elmot/FoxilloScope/DEVELOPMENT.md

# FoxilloScope – Developer & Contributor Guide

This guide provides technical information for developers building firmware, setting up hardware debug configurations, and contributing to the FoxilloScope project.

For end-user quick start instructions and assembly steps, see [README.md](README.md).

---

## 🤖 AI-Assisted Development Invitation

Feel free to use AI coding agents (such as Google Antigravity, Claude, ChatGPT, Cursor, etc.) to modify, extend, or adapt this project to your needs!

To make AI pair-programming seamless and reliable, dedicated **`AGENTS.md`** context files are placed throughout every subsystem directory:
- **Root / STM32 Firmware**: [AGENTS.md](AGENTS.md) – Covers MCU AFE scaling math, ADC phase interleaving, trigger engine, and dual UART DMA transmission.
- **ESP32 Gateway Subsystem**: [esp32-gateway/AGENTS.md](esp32-gateway/AGENTS.md) – Covers WebSocket/BLE streaming, network configuration, and AN3155 in-application STM32 firmware flashing.
- **Web Frontend Subsystem**: [html/AGENTS.md](html/AGENTS.md) – Covers uPlot integration, custom canvas drawing hooks, parameter scaling, and gesture interactions.

---

## Subsystem Architecture & Codebase Structure

The project is split into three main software components:

- **[STM32 Firmware](AGENTS.md)** (`Core/`) – Runs on the STM32G474RET6 MCU. Handles high-speed ADC sampling, hardware AFE scaling, trigger logic, and dual UART DMA transmission.
- **[ESP32 Gateway Firmware](esp32-gateway/AGENTS.md)** (`esp32-gateway/`) – ESP-IDF v6.0 project. While an M5Stamp C3U (ESP32-C3) is used by default, **any Wi-Fi/BLE-enabled ESP32 chip or board** (e.g., ESP32, ESP32-C3/C5/C6, ESP32-S2/S3) supported by ESP-IDF can be used. Refer to the official [ESP-IDF Target Hardware Documentation](https://docs.espressif.com/projects/esp-idf/en/v6.0/esp32/get-started/index.html#target-hardware) for configuring alternative target chips (`idf.py set-target <chip>`).
- **[Web Frontend](html/AGENTS.md)** (`html/`) – Single-page HTML/JS application (`index.html`) using uPlot for real-time waveform rendering, gesture interactions, gain scaling, and measurement readouts.
- **Hardware Documentation** (`docs/`) – Wiring diagrams, pin maps, and schematics.
- **Python Debug Server** (`py/`) – Local desktop development bridge over USB Serial.

---

## Hardware Configuration & Jumper Settings

All hardware modifications, jumper settings (Production vs. Development modes), and pin diagnostics are documented in the **[Hardware Guide (docs/HARDWARE.md)](docs/HARDWARE.md)**:
- **Production Mode**: See [docs/HARDWARE.md#2-jumper-configurations](docs/HARDWARE.md#2-jumper-configurations)
- **Development & ST-LINK Debug Mode**: See [docs/HARDWARE.md#2-jumper-configurations](docs/HARDWARE.md#2-jumper-configurations)
- **Nucleo Board Solder Bridges**: See [docs/HARDWARE.md](docs/HARDWARE.md#1-nucleo-g474re-board-modifications-mandatory)
- **Hardware Verification (`pin_check`)**: See [docs/HARDWARE.md](docs/HARDWARE.md#4-hardware-verification-with-pin_check)

---

## Python Debug Server (Desktop Development)

From the repository root, create a local virtual environment and install the Python dependencies:

```sh
python3 -m venv .venv
source .venv/bin/activate
python -m pip install -r py/requirements.txt
cd py
```

The `.venv` directory is ignored by Git.

For local web UI development without needing the ESP32 gateway hardware, run the Python debug server ([py/chart_server.py](py/chart_server.py)) on a desktop PC:

```sh
python chart_server.py
```

This bridges the STM32's USB Virtual COM port (LPUART1) directly to a local WebSocket server at `http://localhost:8000/`.

### Mock Oscilloscope Server (No Hardware)

To run the complete browser UI without an STM32 or ESP32, start the synthetic signal server:

```sh
python mock_server.py
```

Open `http://localhost:8000/`, select **Oscilloscope UI**, and click the Wi-Fi button. The mock server streams a 50 Hz sine wave on channel A and a 20 Hz square wave on channel B, so changing the sampling timescale changes the visible time span just as it would for physical signals. Trigger keyframes follow the selected channel, threshold, slope, and time offset.

If port 8000 is already in use, stop the existing server or select another port with `python mock_server.py --port 8001`. Run `python mock_server.py --help` for all options.

Run the mock server tests with:

```sh
python -m unittest -v test_mock_server.py
```

---

## Tools Used & Reference Links

- **STM32 Firmware**:
  - [STM32CubeMX](https://www.st.com/en/development-tools/stm32cubemx.html) – Graphical peripheral configuration tool
  - [STM32CubeCLT](https://www.st.com/en/development-tools/stm32cubeclt.html) – Command-line build toolset and GCC ARM toolchain
  - [JetBrains CLion](https://www.jetbrains.com/clion/) – Cross-platform C/C++ IDE
- **ESP32 Gateway**:
  - [Espressif ESP-IDF v6.0](https://docs.espressif.com/projects/esp-idf/en/v6.0/esp32/) – Official development framework for ESP32 chips
- **Schematics & Wiring**:
  - [DigiKey Scheme-it](https://www.digikey.com/schemeit/project/) – Free online schematic capture tool
- **Web Frontend**:
  - Vanilla JavaScript
  - [uPlot](https://github.com/leeoniya/uPlot) – Fast, lightweight 2D canvas charting engine
  - [Lucide Icons](https://lucide.dev/) – Open-source icon library

---

## Documentation References

- User Guide & Assembly: [README.md](README.md)
- STM32 Architecture Reference: [AGENTS.md](AGENTS.md)
- ESP32 Gateway Architecture Reference: [esp32-gateway/AGENTS.md](esp32-gateway/AGENTS.md)
- Frontend Architecture Reference: [html/AGENTS.md](html/AGENTS.md)
- Pinout & Wiring Mapping: [docs/wiring_diagram.html](docs/wiring_diagram.html)
- _(requires LibreOffice or OpenOffice)__ Peripheral functions and pins spreadsheet [docs/foxilloscope_peripherals.fods](docs/foxilloscope_peripherals.fods)
