elmot/FoxilloScope/docs/nucleo-g474re-bottom.jpg

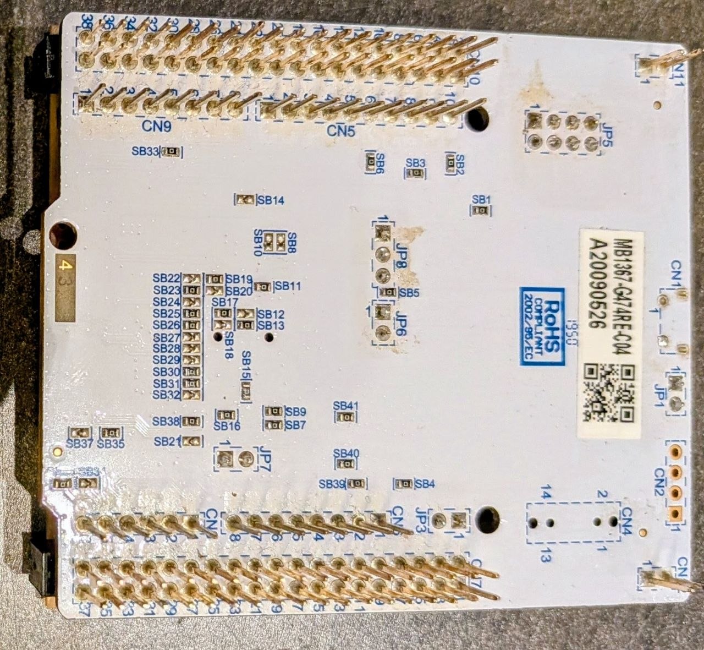
docs/nucleo-g474re-bottom.jpg
