elmot/FoxilloScope/docs/nucleo-g474re-pinout.png

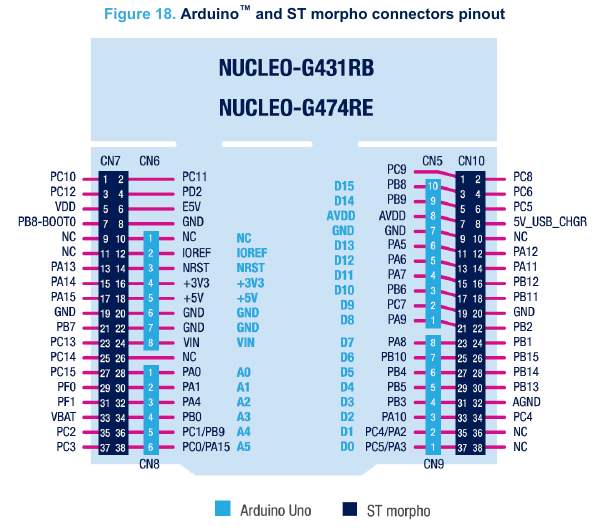
docs/nucleo-g474re-pinout.png
