elmot/FoxilloScope/html/screenshot1.png

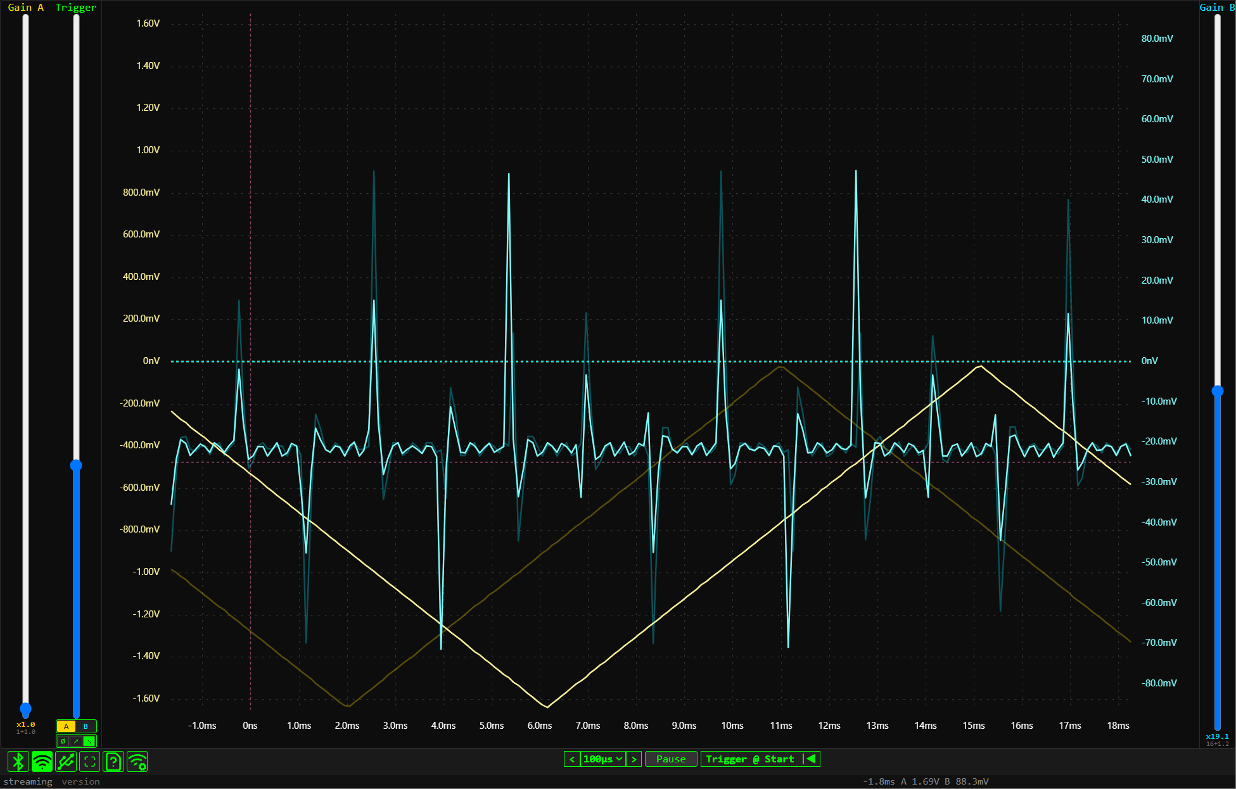
html/screenshot1.png
