elmot/FoxilloScope/html/sticker/background.png

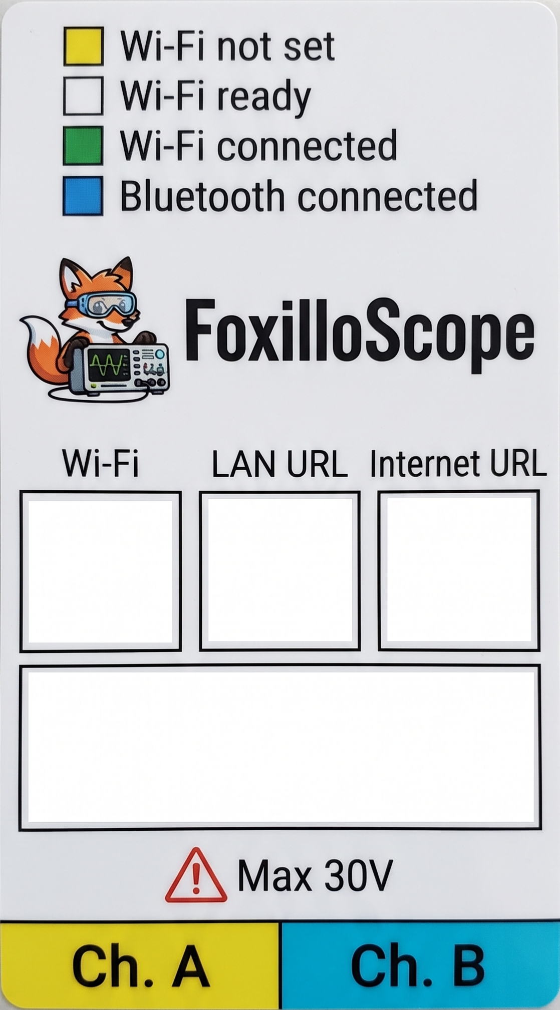
html/sticker/background.png
