elmot/FoxilloScope/Foxilloscope - stripboard.pdf

## Foxilloscope | placement (component side)

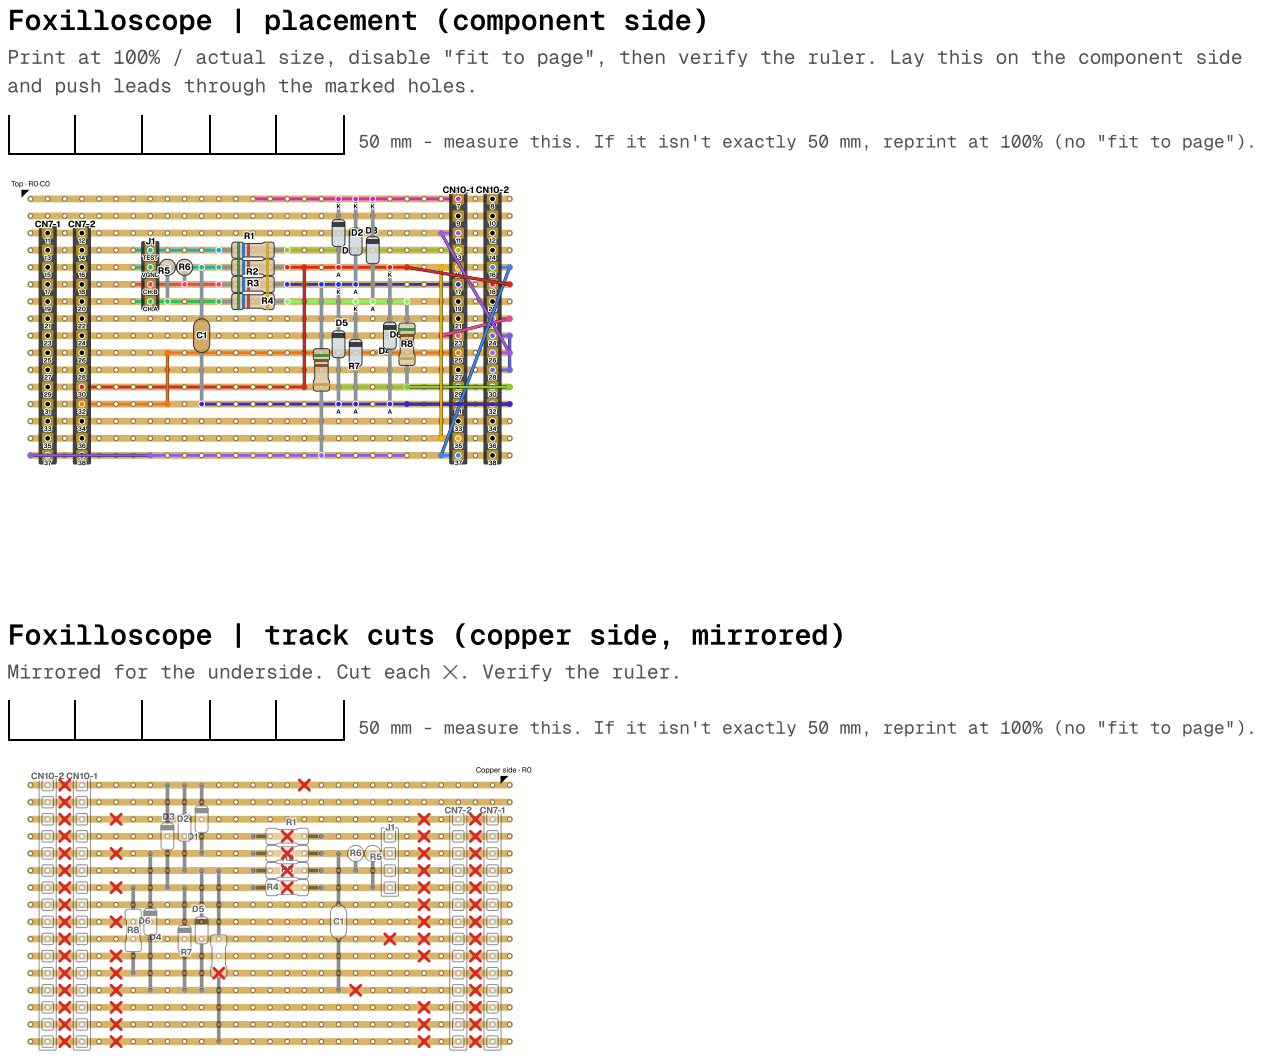
[picture p11: page 1]

Print at 100% / actual size, disable "fit to page", then verify the ruler. Lay this on the component side
and push leads through the marked holes.

50 mm - measure this. If it isn't exactly 50 mm, reprint at 100% (no "fit to page").

Foxilloscope | track cuts (copper side, mirrored)
Mirrored for the underside. Cut each ✕. Verify the ruler.
