elmot/FoxilloScope/foxilloscope.ioc

Mcu.UserName=STM32G474RETx
PA1.GPIO_Label=OPAMP3.IN+[VGND]
PA1.Signal=OPAMP3_VINP
PA13.Signal=SYS_JTMS-SWDIO
PA14.Signal=SYS_JTCK-SWCLK
PA2.GPIO_Label=ADC1.3, OPAMP1_OUT[_SIGNAL.A]
PA2.Signal=SharedAnalog_PA2
PA3.GPIO_Label=OPAMP1.IN-[_STAGE.A]
PA3.Signal=OPAMP1_VINM0
PA4.GPIO_Label=DAC1.1[_BIAS.A]
PA4.Signal=COMP_DAC11_group
PA5.GPIO_Label=DAC1.2[_BIAS.B]
PA5.Signal=COMP_DAC12_group
PA6.GPIO_Label=DAC2.1[TEST.SIGNAL]
PA6.Signal=COMP_DAC21_group
PA7.GPIO_Label=ADC2.4,COMP2+[_SIGNAL_A]
PA7.Signal=SharedAnalog_PA7
PA8.GPIO_Label=OPAMP5.OUT[_STAGE.B]
PA8.Signal=OPAMP5_VOUT
PB1.GPIO_Label=OPAMP3.OUT,ADC3.1[_SIGNAL.B]
PB1.Signal=SharedAnalog_PB1
PB10.GPIO_Label=OPAMP4.IN-[_BIAS.A]
PB10.Signal=OPAMP4_VINM0
PB11.GPIO_Label=OPAMP6.OUT[VGND]
PB11.Signal=OPAMP6_VOUT
PB12.GPIO_Label=OPAMP4.OUT[_STAGE.A]
PB12.Signal=OPAMP4_VOUT
PB13.GPIO_Label=OPAMP4.IN+[IN.A]
PB13.Signal=OPAMP4_VINP
PB14.GPIO_Label=ADC4.4, COMP7+[_SIGNAL.B]
PB14.Signal=SharedAnalog_PB14
PB15.GPIO_Label=OPAMP5.IN-[_BIAS.B]
PB15.Signal=OPAMP5_VINM0
PB2.GPIO_Label=OPAMP3.IN-[_STAGE.B]
PB2.Signal=OPAMP3_VINM0
PC10.GPIO_Label=UART4.TX[EXT.UART.TX]
PC10.Signal=UART4_TX
PC11.GPIO_Label=UART4.RX[EXT.UART.RX]
PC11.Signal=UART4_RX
PC3.GPIO_Label=OPAMP5.IN+[IN.B]
PC3.Signal=OPAMP5_VINP
PC4.Signal=USART1_TX
PC5.Signal=USART1_RX
PF0-OSC_IN.Signal=RCC_OSC_IN
PF1-OSC_OUT.Signal=RCC_OSC_OUT
