elmot/FoxilloScope/Core/Src/main.c

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
/* Includes ------------------------------------------------------------------*/
#include "main.h"
#include "cmsis_os.h"
#include "adc.h"
#include "comp.h"
#include "dac.h"
#include "dma.h"
#include "opamp.h"
#include "tim.h"
#include "usart.h"
#include "gpio.h"


void SystemClock_Config(void);
void MX_FREERTOS_Init(void);
/* USER CODE BEGIN 0 */
void startSysBootloader(void)
{
  __disable_irq();

  /* Stop peripherals, SysTick, DMA, etc. */

  HAL_RCC_DeInit();
  HAL_DeInit();

  SysTick->CTRL = 0;
  SysTick->LOAD = 0;
  SysTick->VAL = 0;

  /* Remap System Memory */
  __HAL_SYSCFG_REMAPMEMORY_SYSTEMFLASH();

  /* Load MSP from System Memory */
  const uint32_t bootAddr = 0x1FFF0000;   // STM32G4 System Memory start
  __set_MSP(*(uint32_t *)bootAddr);

  /* Jump to Reset_Handler in System Memory */
  void (*SysMemBootJump)(void) = (void (*)(void))(*(uint32_t*)(bootAddr + 4));
  SysMemBootJump();

}
/* USER CODE END 0 */

/**
  * @brief  The application entry point.
  * @retval int
  */
int main(void)
{

  /* MCU Configuration--------------------------------------------------------*/

  /* Reset of all peripherals, Initializes the Flash interface and the Systick. */
  HAL_Init();

  /* Configure the system clock */
  SystemClock_Config();

  /* Initialize all configured peripherals */
  MX_GPIO_Init();
  MX_DMA_Init();
  MX_DAC1_Init();
  MX_TIM1_Init();
  MX_TIM15_Init();
  MX_TIM2_Init();
  MX_DAC3_Init();
  MX_ADC1_Init();
  MX_ADC2_Init();
  MX_UART4_Init();
  MX_ADC3_Init();
  MX_ADC4_Init();
  MX_DAC2_Init();
  MX_USART1_UART_Init();
  MX_OPAMP6_Init();
  MX_OPAMP1_Init();
  MX_OPAMP4_Init();
  MX_OPAMP3_Init();
  MX_OPAMP5_Init();
  MX_COMP2_Init();
  MX_COMP7_Init();
  MX_DAC4_Init();
  /* Init scheduler */
  osKernelInitialize();  /* Call init function for freertos objects (in cmsis_os2.c) */
  MX_FREERTOS_Init();

  /* Start scheduler */
  osKernelStart();

  /* We should never get here as control is now taken by the scheduler */

  /* Infinite loop */
}

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
/**
  * @brief  Period elapsed callback in non blocking mode
  * @note   This function is called  when TIM7 interrupt took place, inside
  * HAL_TIM_IRQHandler(). It makes a direct call to HAL_IncTick() to increment
  * a global variable "uwTick" used as application time base.
  * @param  htim : TIM handle
  * @retval None
  */
void HAL_TIM_PeriodElapsedCallback(TIM_HandleTypeDef *htim)
{
  if (htim->Instance == TIM7)
  {
    HAL_IncTick();
  }
}

/**
  * @brief  This function is executed in case of error occurrence.
  * @retval None
  */
void Error_Handler(void)
{
  /* USER CODE BEGIN Error_Handler_Debug */
  /* User can add his own implementation to report the HAL error return state */
  __disable_irq();
  // ReSharper disable once CppDFAEndlessLoop
  while (1)
  {
  }
  /* USER CODE END Error_Handler_Debug */
}
#ifdef USE_FULL_ASSERT
/**
  * @brief  Reports the name of the source file and the source line number
  *         where the assert_param error has occurred.
  * @param  file: pointer to the source file name
  * @param  line: assert_param error line source number
  * @retval None
  */
void assert_failed(uint8_t *file, uint32_t line)
{
  /* USER CODE BEGIN 6 */
  /* User can add his own implementation to report the file name and line number,
     ex: printf("Wrong parameters value: file %s on line %d\r\n", file, line) */
  /* USER CODE END 6 */
}
#endif /* USE_FULL_ASSERT */
