elmot/FoxilloScope/Core/Src/adc.c

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
/* Includes ------------------------------------------------------------------*/
#include "adc.h"

/* USER CODE BEGIN 0 */
#include "cmsis_os2.h"
#include "tim.h"
#include "stdbool.h"

/* USER CODE END 0 */

ADC_HandleTypeDef hadc1;
ADC_HandleTypeDef hadc2;
ADC_HandleTypeDef hadc3;
ADC_HandleTypeDef hadc4;
DMA_HandleTypeDef hdma_adc1;
DMA_HandleTypeDef hdma_adc3;

/* ADC1 init function */
void MX_ADC1_Init(void)
{

  ADC_MultiModeTypeDef multimode = {0};
  ADC_ChannelConfTypeDef sConfig = {0};
  ADC_InjectionConfTypeDef sConfigInjected = {0};

  /** Common config
  */
  hadc1.Instance = ADC1;
  hadc1.Init.ClockPrescaler = ADC_CLOCK_ASYNC_DIV1;
  hadc1.Init.Resolution = ADC_RESOLUTION_12B;
  hadc1.Init.DataAlign = ADC_DATAALIGN_RIGHT;
  hadc1.Init.GainCompensation = 0;
  hadc1.Init.ScanConvMode = ADC_SCAN_DISABLE;
  hadc1.Init.EOCSelection = ADC_EOC_SINGLE_CONV;
  hadc1.Init.LowPowerAutoWait = DISABLE;
  hadc1.Init.ContinuousConvMode = DISABLE;
  hadc1.Init.NbrOfConversion = 1;
  hadc1.Init.DiscontinuousConvMode = DISABLE;
  hadc1.Init.ExternalTrigConv = ADC_EXTERNALTRIG_T2_TRGO;
  hadc1.Init.ExternalTrigConvEdge = ADC_EXTERNALTRIGCONVEDGE_RISING;
  hadc1.Init.DMAContinuousRequests = ENABLE;
  hadc1.Init.Overrun = ADC_OVR_DATA_OVERWRITTEN;
  hadc1.Init.OversamplingMode = DISABLE;
  if (HAL_ADC_Init(&hadc1) != HAL_OK)
  {
    Error_Handler();
  }

  /** Configure the ADC multi-mode
  */
  multimode.Mode = ADC_DUALMODE_REGINTERL_INJECSIMULT;
  multimode.DMAAccessMode = ADC_DMAACCESSMODE_12_10_BITS;
  multimode.TwoSamplingDelay = ADC_TWOSAMPLINGDELAY_7CYCLES;
  if (HAL_ADCEx_MultiModeConfigChannel(&hadc1, &multimode) != HAL_OK)
  {
    Error_Handler();
  }

  /** Configure Regular Channel
  */
  sConfig.Channel = ADC_CHANNEL_3;
  sConfig.Rank = ADC_REGULAR_RANK_1;
  sConfig.SamplingTime = ADC_SAMPLETIME_2CYCLES_5;
  sConfig.SingleDiff = ADC_SINGLE_ENDED;
  sConfig.OffsetNumber = ADC_OFFSET_NONE;
  sConfig.Offset = 0;
  if (HAL_ADC_ConfigChannel(&hadc1, &sConfig) != HAL_OK)
  {
    Error_Handler();
  }

  /** Configure Injected Channel
  */
  sConfigInjected.InjectedChannel = ADC_CHANNEL_VREFINT;
  sConfigInjected.InjectedRank = ADC_INJECTED_RANK_1;
  sConfigInjected.InjectedSamplingTime = ADC_SAMPLETIME_640CYCLES_5;
  sConfigInjected.InjectedSingleDiff = ADC_SINGLE_ENDED;
  sConfigInjected.InjectedOffsetNumber = ADC_OFFSET_NONE;
  sConfigInjected.InjectedOffset = 0;
  sConfigInjected.InjectedNbrOfConversion = 1;
  sConfigInjected.InjectedDiscontinuousConvMode = DISABLE;
  sConfigInjected.AutoInjectedConv = DISABLE;
  sConfigInjected.QueueInjectedContext = DISABLE;
  sConfigInjected.ExternalTrigInjecConv = ADC_INJECTED_SOFTWARE_START;
  sConfigInjected.ExternalTrigInjecConvEdge = ADC_EXTERNALTRIGINJECCONV_EDGE_NONE;
  sConfigInjected.InjecOversamplingMode = DISABLE;
  if (HAL_ADCEx_InjectedConfigChannel(&hadc1, &sConfigInjected) != HAL_OK)
  {
    Error_Handler();
  }
}
/* ADC2 init function */
void MX_ADC2_Init(void)
{

  ADC_ChannelConfTypeDef sConfig = {0};

  /** Common config
  */
  hadc2.Instance = ADC2;
  hadc2.Init.ClockPrescaler = ADC_CLOCK_ASYNC_DIV1;
  hadc2.Init.Resolution = ADC_RESOLUTION_12B;
  hadc2.Init.DataAlign = ADC_DATAALIGN_RIGHT;
  hadc2.Init.GainCompensation = 0;
  hadc2.Init.ScanConvMode = ADC_SCAN_DISABLE;
  hadc2.Init.EOCSelection = ADC_EOC_SINGLE_CONV;
  hadc2.Init.LowPowerAutoWait = DISABLE;
  hadc2.Init.ContinuousConvMode = DISABLE;
  hadc2.Init.NbrOfConversion = 1;
  hadc2.Init.DiscontinuousConvMode = DISABLE;
  hadc2.Init.DMAContinuousRequests = DISABLE;
  hadc2.Init.Overrun = ADC_OVR_DATA_OVERWRITTEN;
  hadc2.Init.OversamplingMode = DISABLE;
  if (HAL_ADC_Init(&hadc2) != HAL_OK)
  {
    Error_Handler();
  }

  /** Configure Regular Channel
  */
  sConfig.Channel = ADC_CHANNEL_4;
  sConfig.Rank = ADC_REGULAR_RANK_1;
  sConfig.SamplingTime = ADC_SAMPLETIME_2CYCLES_5;
  sConfig.SingleDiff = ADC_SINGLE_ENDED;
  sConfig.OffsetNumber = ADC_OFFSET_NONE;
  sConfig.Offset = 0;
  if (HAL_ADC_ConfigChannel(&hadc2, &sConfig) != HAL_OK)
  {
    Error_Handler();
  }
}
/* ADC3 init function */
void MX_ADC3_Init(void)
{

  ADC_MultiModeTypeDef multimode = {0};
  ADC_ChannelConfTypeDef sConfig = {0};

  /** Common config
  */
  hadc3.Instance = ADC3;
  hadc3.Init.ClockPrescaler = ADC_CLOCK_ASYNC_DIV1;
  hadc3.Init.Resolution = ADC_RESOLUTION_12B;
  hadc3.Init.DataAlign = ADC_DATAALIGN_RIGHT;
  hadc3.Init.GainCompensation = 0;
  hadc3.Init.ScanConvMode = ADC_SCAN_DISABLE;
  hadc3.Init.EOCSelection = ADC_EOC_SINGLE_CONV;
  hadc3.Init.LowPowerAutoWait = DISABLE;
  hadc3.Init.ContinuousConvMode = DISABLE;
  hadc3.Init.NbrOfConversion = 1;
  hadc3.Init.DiscontinuousConvMode = DISABLE;
  hadc3.Init.ExternalTrigConv = ADC_EXTERNALTRIG_T2_TRGO;
  hadc3.Init.ExternalTrigConvEdge = ADC_EXTERNALTRIGCONVEDGE_RISING;
  hadc3.Init.DMAContinuousRequests = ENABLE;
  hadc3.Init.Overrun = ADC_OVR_DATA_OVERWRITTEN;
  hadc3.Init.OversamplingMode = DISABLE;
  if (HAL_ADC_Init(&hadc3) != HAL_OK)
  {
    Error_Handler();
  }

  /** Configure the ADC multi-mode
  */
  multimode.Mode = ADC_DUALMODE_INTERL;
  multimode.DMAAccessMode = ADC_DMAACCESSMODE_12_10_BITS;
  multimode.TwoSamplingDelay = ADC_TWOSAMPLINGDELAY_7CYCLES;
  if (HAL_ADCEx_MultiModeConfigChannel(&hadc3, &multimode) != HAL_OK)
  {
    Error_Handler();
  }

  /** Configure Regular Channel
  */
  sConfig.Channel = ADC_CHANNEL_1;
  sConfig.Rank = ADC_REGULAR_RANK_1;
  sConfig.SamplingTime = ADC_SAMPLETIME_2CYCLES_5;
  sConfig.SingleDiff = ADC_SINGLE_ENDED;
  sConfig.OffsetNumber = ADC_OFFSET_NONE;
  sConfig.Offset = 0;
  if (HAL_ADC_ConfigChannel(&hadc3, &sConfig) != HAL_OK)
  {
    Error_Handler();
  }
}
/* ADC4 init function */
void MX_ADC4_Init(void)
{

  ADC_ChannelConfTypeDef sConfig = {0};

  /** Common config
  */
  hadc4.Instance = ADC4;
  hadc4.Init.ClockPrescaler = ADC_CLOCK_ASYNC_DIV1;
  hadc4.Init.Resolution = ADC_RESOLUTION_12B;
  hadc4.Init.DataAlign = ADC_DATAALIGN_RIGHT;
  hadc4.Init.GainCompensation = 0;
  hadc4.Init.ScanConvMode = ADC_SCAN_DISABLE;
  hadc4.Init.EOCSelection = ADC_EOC_SINGLE_CONV;
  hadc4.Init.LowPowerAutoWait = DISABLE;
  hadc4.Init.ContinuousConvMode = DISABLE;
  hadc4.Init.NbrOfConversion = 1;
  hadc4.Init.DiscontinuousConvMode = DISABLE;
  hadc4.Init.DMAContinuousRequests = DISABLE;
  hadc4.Init.Overrun = ADC_OVR_DATA_OVERWRITTEN;
  hadc4.Init.OversamplingMode = DISABLE;
  if (HAL_ADC_Init(&hadc4) != HAL_OK)
  {
    Error_Handler();
  }

  /** Configure Regular Channel
  */
  sConfig.Channel = ADC_CHANNEL_4;
  sConfig.Rank = ADC_REGULAR_RANK_1;
  sConfig.SamplingTime = ADC_SAMPLETIME_2CYCLES_5;
  sConfig.SingleDiff = ADC_SINGLE_ENDED;
  sConfig.OffsetNumber = ADC_OFFSET_NONE;
  sConfig.Offset = 0;
  if (HAL_ADC_ConfigChannel(&hadc4, &sConfig) != HAL_OK)
  {
    Error_Handler();
  }
}

static uint32_t HAL_RCC_ADC12_CLK_ENABLED=0;
static uint32_t HAL_RCC_ADC345_CLK_ENABLED=0;

void HAL_ADC_MspInit(ADC_HandleTypeDef* adcHandle)
{

  GPIO_InitTypeDef GPIO_InitStruct = {0};
  RCC_PeriphCLKInitTypeDef PeriphClkInit = {0};
  if(adcHandle->Instance==ADC1)
  {
  /** Initializes the peripherals clocks
  */
    PeriphClkInit.PeriphClockSelection = RCC_PERIPHCLK_ADC12;
    PeriphClkInit.Adc12ClockSelection = RCC_ADC12CLKSOURCE_PLL;
    if (HAL_RCCEx_PeriphCLKConfig(&PeriphClkInit) != HAL_OK)
    {
      Error_Handler();
    }

    /* ADC1 clock enable */
    HAL_RCC_ADC12_CLK_ENABLED++;
    if(HAL_RCC_ADC12_CLK_ENABLED==1){
      __HAL_RCC_ADC12_CLK_ENABLE();
    }

    __HAL_RCC_GPIOA_CLK_ENABLE();
    /**ADC1 GPIO Configuration
    PA2     ------> ADC1_IN3
    */
    GPIO_InitStruct.Pin = ADC1_3__OPAMP1_OUT_Pin;
    GPIO_InitStruct.Mode = GPIO_MODE_ANALOG;
    GPIO_InitStruct.Pull = GPIO_NOPULL;
    HAL_GPIO_Init(ADC1_3__OPAMP1_OUT_GPIO_Port, &GPIO_InitStruct);

    /* ADC1 DMA Init */
    /* ADC1 Init */
    hdma_adc1.Instance = DMA1_Channel5;
    hdma_adc1.Init.Request = DMA_REQUEST_ADC1;
    hdma_adc1.Init.Direction = DMA_PERIPH_TO_MEMORY;
    hdma_adc1.Init.PeriphInc = DMA_PINC_DISABLE;
    hdma_adc1.Init.MemInc = DMA_MINC_ENABLE;
    hdma_adc1.Init.PeriphDataAlignment = DMA_PDATAALIGN_WORD;
    hdma_adc1.Init.MemDataAlignment = DMA_MDATAALIGN_WORD;
    hdma_adc1.Init.Mode = DMA_CIRCULAR;
    hdma_adc1.Init.Priority = DMA_PRIORITY_LOW;
    if (HAL_DMA_Init(&hdma_adc1) != HAL_OK)
    {
      Error_Handler();
    }

    __HAL_LINKDMA(adcHandle,DMA_Handle,hdma_adc1);

  }
  else if(adcHandle->Instance==ADC2)
  {
  /** Initializes the peripherals clocks
  */
    PeriphClkInit.PeriphClockSelection = RCC_PERIPHCLK_ADC12;
    PeriphClkInit.Adc12ClockSelection = RCC_ADC12CLKSOURCE_PLL;
    if (HAL_RCCEx_PeriphCLKConfig(&PeriphClkInit) != HAL_OK)
    {
      Error_Handler();
    }

    /* ADC2 clock enable */
    HAL_RCC_ADC12_CLK_ENABLED++;
    if(HAL_RCC_ADC12_CLK_ENABLED==1){
      __HAL_RCC_ADC12_CLK_ENABLE();
    }

    __HAL_RCC_GPIOA_CLK_ENABLE();
    /**ADC2 GPIO Configuration
    PA7     ------> ADC2_IN4
    */
    GPIO_InitStruct.Pin = ADC2_4_COMP2__Pin;
    GPIO_InitStruct.Mode = GPIO_MODE_ANALOG;
    GPIO_InitStruct.Pull = GPIO_NOPULL;
    HAL_GPIO_Init(ADC2_4_COMP2__GPIO_Port, &GPIO_InitStruct);

  }
  else if(adcHandle->Instance==ADC3)
  {
  /** Initializes the peripherals clocks
  */
    PeriphClkInit.PeriphClockSelection = RCC_PERIPHCLK_ADC345;
    PeriphClkInit.Adc345ClockSelection = RCC_ADC345CLKSOURCE_PLL;
    if (HAL_RCCEx_PeriphCLKConfig(&PeriphClkInit) != HAL_OK)
    {
      Error_Handler();
    }

    /* ADC3 clock enable */
    HAL_RCC_ADC345_CLK_ENABLED++;
    if(HAL_RCC_ADC345_CLK_ENABLED==1){
      __HAL_RCC_ADC345_CLK_ENABLE();
    }

    __HAL_RCC_GPIOB_CLK_ENABLE();
    /**ADC3 GPIO Configuration
    PB1     ------> ADC3_IN1
    */
    GPIO_InitStruct.Pin = OPAMP3_OUT_ADC3_1_Pin;
    GPIO_InitStruct.Mode = GPIO_MODE_ANALOG;
    GPIO_InitStruct.Pull = GPIO_NOPULL;
    HAL_GPIO_Init(OPAMP3_OUT_ADC3_1_GPIO_Port, &GPIO_InitStruct);

    /* ADC3 DMA Init */
    /* ADC3 Init */
    hdma_adc3.Instance = DMA1_Channel3;
    hdma_adc3.Init.Request = DMA_REQUEST_ADC3;
    hdma_adc3.Init.Direction = DMA_PERIPH_TO_MEMORY;
    hdma_adc3.Init.PeriphInc = DMA_PINC_DISABLE;
    hdma_adc3.Init.MemInc = DMA_MINC_ENABLE;
    hdma_adc3.Init.PeriphDataAlignment = DMA_PDATAALIGN_WORD;
    hdma_adc3.Init.MemDataAlignment = DMA_MDATAALIGN_WORD;
    hdma_adc3.Init.Mode = DMA_CIRCULAR;
    hdma_adc3.Init.Priority = DMA_PRIORITY_LOW;
    if (HAL_DMA_Init(&hdma_adc3) != HAL_OK)
    {
      Error_Handler();
    }

    __HAL_LINKDMA(adcHandle,DMA_Handle,hdma_adc3);

  }
  else if(adcHandle->Instance==ADC4)
  {
  /** Initializes the peripherals clocks
  */
    PeriphClkInit.PeriphClockSelection = RCC_PERIPHCLK_ADC345;
    PeriphClkInit.Adc345ClockSelection = RCC_ADC345CLKSOURCE_PLL;
    if (HAL_RCCEx_PeriphCLKConfig(&PeriphClkInit) != HAL_OK)
    {
      Error_Handler();
    }

    /* ADC4 clock enable */
    HAL_RCC_ADC345_CLK_ENABLED++;
    if(HAL_RCC_ADC345_CLK_ENABLED==1){
      __HAL_RCC_ADC345_CLK_ENABLE();
    }

    __HAL_RCC_GPIOB_CLK_ENABLE();
    /**ADC4 GPIO Configuration
    PB14     ------> ADC4_IN4
    */
    GPIO_InitStruct.Pin = ADC4_4__COMP7__Pin;
    GPIO_InitStruct.Mode = GPIO_MODE_ANALOG;
    GPIO_InitStruct.Pull = GPIO_NOPULL;
    HAL_GPIO_Init(ADC4_4__COMP7__GPIO_Port, &GPIO_InitStruct);

  }
}

void HAL_ADC_MspDeInit(ADC_HandleTypeDef* adcHandle)
{

  if(adcHandle->Instance==ADC1)
  {
    /* Peripheral clock disable */
    HAL_RCC_ADC12_CLK_ENABLED--;
    if(HAL_RCC_ADC12_CLK_ENABLED==0){
      __HAL_RCC_ADC12_CLK_DISABLE();
    }

    /**ADC1 GPIO Configuration
    PA2     ------> ADC1_IN3
    */
    HAL_GPIO_DeInit(ADC1_3__OPAMP1_OUT_GPIO_Port, ADC1_3__OPAMP1_OUT_Pin);

    /* ADC1 DMA DeInit */
    HAL_DMA_DeInit(adcHandle->DMA_Handle);
  }
  else if(adcHandle->Instance==ADC2)
  {
    /* Peripheral clock disable */
    HAL_RCC_ADC12_CLK_ENABLED--;
    if(HAL_RCC_ADC12_CLK_ENABLED==0){
      __HAL_RCC_ADC12_CLK_DISABLE();
    }

    /**ADC2 GPIO Configuration
    PA7     ------> ADC2_IN4
    */
    HAL_GPIO_DeInit(ADC2_4_COMP2__GPIO_Port, ADC2_4_COMP2__Pin);

  }
  else if(adcHandle->Instance==ADC3)
  {
    /* Peripheral clock disable */
    HAL_RCC_ADC345_CLK_ENABLED--;
    if(HAL_RCC_ADC345_CLK_ENABLED==0){
      __HAL_RCC_ADC345_CLK_DISABLE();
    }

    /**ADC3 GPIO Configuration
    PB1     ------> ADC3_IN1
    */
    HAL_GPIO_DeInit(OPAMP3_OUT_ADC3_1_GPIO_Port, OPAMP3_OUT_ADC3_1_Pin);

    /* ADC3 DMA DeInit */
    HAL_DMA_DeInit(adcHandle->DMA_Handle);
  }
  else if(adcHandle->Instance==ADC4)
  {
    /* Peripheral clock disable */
    HAL_RCC_ADC345_CLK_ENABLED--;
    if(HAL_RCC_ADC345_CLK_ENABLED==0){
      __HAL_RCC_ADC345_CLK_DISABLE();
    }

    /**ADC4 GPIO Configuration
    PB14     ------> ADC4_IN4
    */
    HAL_GPIO_DeInit(ADC4_4__COMP7__GPIO_Port, ADC4_4__COMP7__Pin);

  }
}

/* USER CODE BEGIN 1 */
void initFrameTransfer(int subBufferIndex);

void HAL_ADC_ConvHalfCpltCallback(ADC_HandleTypeDef* hadc)
{
  UNUSED(hadc);
  initFrameTransfer(0);
}

void HAL_ADC_ConvCpltCallback(ADC_HandleTypeDef* hadc)
{
    UNUSED(hadc);
    initFrameTransfer(1);
}

uint16_t analog_supply_voltage_mV;

void adcCalibration()
{
  HAL_ADCEx_Calibration_Start(&hadc1, ADC_SINGLE_ENDED);
  HAL_ADCEx_Calibration_Start(&hadc2, ADC_SINGLE_ENDED);
  HAL_ADCEx_Calibration_Start(&hadc3, ADC_SINGLE_ENDED);
  HAL_ADCEx_Calibration_Start(&hadc4, ADC_SINGLE_ENDED);
  HAL_ADCEx_InjectedStart(&hadc1);
  while (HAL_ADCEx_InjectedPollForConversion(&hadc1,0) != HAL_OK)
  {
    osThreadYield();
  }
  const uint32_t vRefReading = HAL_ADCEx_InjectedGetValue(&hadc1, ADC_INJECTED_RANK_1);
  analog_supply_voltage_mV = __LL_ADC_CALC_VREFANALOG_VOLTAGE(vRefReading , LL_ADC_RESOLUTION_12B);
}

/** Sets DMA alignment 16 or 32 bit
 *@param dmaAlign @DMA_Memory_data_size
 */
static void setDmaDataAlign(const uint32_t dmaAlign)
{
    MODIFY_REG(hadc3.DMA_Handle->Instance->CCR, DMA_CCR_MSIZE_Msk, dmaAlign);
    MODIFY_REG(hadc1.DMA_Handle->Instance->CCR, DMA_CCR_MSIZE_Msk, dmaAlign);
    /* Useless, just for consistency */
    hadc3.DMA_Handle->Init.MemDataAlignment = dmaAlign;
    hadc1.DMA_Handle->Init.MemDataAlignment = dmaAlign;
}

/** Sets Continuous Sampling Mode (== max sampling rate)
 */
static void setContinuousSampling(const bool q)
{
    const uint32_t bit = q ? ENABLE:DISABLE;
    const uint32_t v = ADC_CFGR_CONTINUOUS(bit);

    MODIFY_REG(hadc1.Instance->CFGR, ADC_CFGR_CONT_Msk, v);
    MODIFY_REG(hadc3.Instance->CFGR, ADC_CFGR_CONT_Msk, v);
    /* Useless, just for consistency */
    hadc3.Init.ContinuousConvMode = bit;
    hadc1.Init.ContinuousConvMode = bit;
}

void startMainAdcs(const bool interleaveSampling, uint16_t* bufferA, uint16_t* bufferB, const size_t bufferLength)
{
  const bool adc_independent_mode =
    LL_ADC_GetMultimode(__LL_ADC_COMMON_INSTANCE(hadc1.Instance)) == LL_ADC_MULTI_INDEPENDENT;
  if (adc_independent_mode)
  {
    HAL_ADC_Stop_DMA(&hadc1);
    HAL_ADC_Stop_DMA(&hadc3);
  }
  else
  {
    HAL_ADCEx_MultiModeStop_DMA(&hadc1);
    HAL_ADCEx_MultiModeStop_DMA(&hadc3);
  }
  HAL_TIM_Base_Stop(&htim2);
  HAL_TIM_GenerateEvent(&htim1, TIM_EVENTSOURCE_UPDATE);
  __HAL_TIM_CLEAR_FLAG(&htim1, TIM_FLAG_CC1);
  if (interleaveSampling)
  {
    if (adc_independent_mode)
    {
      setDmaDataAlign(DMA_MDATAALIGN_WORD);
      setContinuousSampling(true);
      static const ADC_MultiModeTypeDef multimode = {
        .Mode = ADC_DUALMODE_INTERL,
        .DMAAccessMode = ADC_DMAACCESSMODE_12_10_BITS,
        .TwoSamplingDelay = ADC_TWOSAMPLINGDELAY_6CYCLES
      };
      if (HAL_ADCEx_MultiModeConfigChannel(&hadc1, &multimode) != HAL_OK ||
        HAL_ADCEx_MultiModeConfigChannel(&hadc3, &multimode) != HAL_OK)
      {
        Error_Handler();
      }
    }
    if (HAL_ADCEx_MultiModeStart_DMA(&hadc1, (uint32_t*)bufferA, bufferLength / 2) != HAL_OK ||
      HAL_ADCEx_MultiModeStart_DMA(&hadc3, (uint32_t*)bufferB, bufferLength / 2) != HAL_OK)
    {
      Error_Handler();
    }
  }
  else
  {
    if (!adc_independent_mode)
    {
      setDmaDataAlign(DMA_MDATAALIGN_HALFWORD);
      setContinuousSampling(false);
      static const ADC_MultiModeTypeDef multimode = {.Mode = ADC_MODE_INDEPENDENT};
      if (HAL_ADCEx_MultiModeConfigChannel(&hadc1, &multimode) != HAL_OK ||
        HAL_ADCEx_MultiModeConfigChannel(&hadc3, &multimode) != HAL_OK)
      {
        Error_Handler();
      }
    }
    if (HAL_ADC_Start_DMA(&hadc1, (uint32_t*)bufferA, bufferLength) != HAL_OK ||
      HAL_ADC_Start_DMA(&hadc3, (uint32_t*)bufferB, bufferLength) != HAL_OK)
    {
      Error_Handler();
    }
  }
}

size_t adcSamplesLeft()
{
    const size_t result = hadc3.DMA_Handle->Instance->CNDTR;

    switch (hadc3.DMA_Handle->Instance->CCR & DMA_CCR_MSIZE_Msk)
    {
    case DMA_MDATAALIGN_HALFWORD:
        return result;
    case DMA_MDATAALIGN_WORD:
        return result * 2;
    default: Error_Handler();
        return result - 1;
    }
}

/* USER CODE END 1 */
