elmot/FoxilloScope/Core/Src/dac.c

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
/* Includes ------------------------------------------------------------------*/
#include "dac.h"

DAC_HandleTypeDef hdac1;
DAC_HandleTypeDef hdac2;
DAC_HandleTypeDef hdac3;
DAC_HandleTypeDef hdac4;
DMA_HandleTypeDef hdma_dac2_ch1;

/* DAC1 init function */
void MX_DAC1_Init(void)
{

  DAC_ChannelConfTypeDef sConfig = {0};

  /** DAC Initialization
  */
  hdac1.Instance = DAC1;
  if (HAL_DAC_Init(&hdac1) != HAL_OK)
  {
    Error_Handler();
  }

  /** DAC channel OUT1 config
  */
  sConfig.DAC_HighFrequency = DAC_HIGH_FREQUENCY_INTERFACE_MODE_AUTOMATIC;
  sConfig.DAC_DMADoubleDataMode = DISABLE;
  sConfig.DAC_SignedFormat = DISABLE;
  sConfig.DAC_SampleAndHold = DAC_SAMPLEANDHOLD_DISABLE;
  sConfig.DAC_Trigger = DAC_TRIGGER_NONE;
  sConfig.DAC_Trigger2 = DAC_TRIGGER_NONE;
  sConfig.DAC_OutputBuffer = DAC_OUTPUTBUFFER_ENABLE;
  sConfig.DAC_ConnectOnChipPeripheral = DAC_CHIPCONNECT_EXTERNAL;
  sConfig.DAC_UserTrimming = DAC_TRIMMING_FACTORY;
  if (HAL_DAC_ConfigChannel(&hdac1, &sConfig, DAC_CHANNEL_1) != HAL_OK)
  {
    Error_Handler();
  }

  /** DAC channel OUT2 config
  */
  if (HAL_DAC_ConfigChannel(&hdac1, &sConfig, DAC_CHANNEL_2) != HAL_OK)
  {
    Error_Handler();
  }
  /* USER CODE BEGIN DAC1_Init 2 */
  HAL_DACEx_SelfCalibrate(&BIAS_DAC,&sConfig,BIAS_DAC_CHANNEL_A);
  HAL_DACEx_SelfCalibrate(&BIAS_DAC,&sConfig,BIAS_DAC_CHANNEL_B);

  /* USER CODE END DAC1_Init 2 */

}
/* DAC2 init function */
void MX_DAC2_Init(void)
{

  DAC_ChannelConfTypeDef sConfig = {0};

  /** DAC Initialization
  */
  hdac2.Instance = DAC2;
  if (HAL_DAC_Init(&hdac2) != HAL_OK)
  {
    Error_Handler();
  }

  /** DAC channel OUT1 config
  */
  sConfig.DAC_HighFrequency = DAC_HIGH_FREQUENCY_INTERFACE_MODE_AUTOMATIC;
  sConfig.DAC_DMADoubleDataMode = ENABLE;
  sConfig.DAC_SignedFormat = DISABLE;
  sConfig.DAC_SampleAndHold = DAC_SAMPLEANDHOLD_DISABLE;
  sConfig.DAC_Trigger = DAC_TRIGGER_T15_TRGO;
  sConfig.DAC_Trigger2 = DAC_TRIGGER_NONE;
  sConfig.DAC_OutputBuffer = DAC_OUTPUTBUFFER_ENABLE;
  sConfig.DAC_ConnectOnChipPeripheral = DAC_CHIPCONNECT_EXTERNAL;
  sConfig.DAC_UserTrimming = DAC_TRIMMING_FACTORY;
  if (HAL_DAC_ConfigChannel(&hdac2, &sConfig, DAC_CHANNEL_1) != HAL_OK)
  {
    Error_Handler();
  }
  /* USER CODE BEGIN DAC2_Init 2 */
  HAL_DACEx_SelfCalibrate(&TEST_SIGNAL_DAC,&sConfig,TEST_SIGNAL_DAC_CHANNEL);
  /* USER CODE END DAC2_Init 2 */

}
/* DAC3 init function */
void MX_DAC3_Init(void)
{

  DAC_ChannelConfTypeDef sConfig = {0};

  /** DAC Initialization
  */
  hdac3.Instance = DAC3;
  if (HAL_DAC_Init(&hdac3) != HAL_OK)
  {
    Error_Handler();
  }

  /** DAC channel OUT1 config
  */
  sConfig.DAC_HighFrequency = DAC_HIGH_FREQUENCY_INTERFACE_MODE_DISABLE;
  sConfig.DAC_DMADoubleDataMode = DISABLE;
  sConfig.DAC_SignedFormat = DISABLE;
  sConfig.DAC_SampleAndHold = DAC_SAMPLEANDHOLD_DISABLE;
  sConfig.DAC_Trigger = DAC_TRIGGER_NONE;
  sConfig.DAC_Trigger2 = DAC_TRIGGER_NONE;
  sConfig.DAC_OutputBuffer = DAC_OUTPUTBUFFER_DISABLE;
  sConfig.DAC_ConnectOnChipPeripheral = DAC_CHIPCONNECT_INTERNAL;
  sConfig.DAC_UserTrimming = DAC_TRIMMING_FACTORY;
  if (HAL_DAC_ConfigChannel(&hdac3, &sConfig, DAC_CHANNEL_1) != HAL_OK)
  {
    Error_Handler();
  }

  /** DAC channel OUT2 config
  */
  if (HAL_DAC_ConfigChannel(&hdac3, &sConfig, DAC_CHANNEL_2) != HAL_OK)
  {
    Error_Handler();
  }
  /* USER CODE BEGIN DAC3_Init 2 */
  HAL_DACEx_SelfCalibrate(&VGND_TRG_A_DAC,&sConfig,VGND_DAC_CHANNEL);
  HAL_DACEx_SelfCalibrate(&VGND_TRG_A_DAC,&sConfig,TRG_A_DAC_CHANNEL);
  /* USER CODE END DAC3_Init 2 */

}
/* DAC4 init function */
void MX_DAC4_Init(void)
{

  DAC_ChannelConfTypeDef sConfig = {0};

  /** DAC Initialization
  */
  hdac4.Instance = DAC4;
  if (HAL_DAC_Init(&hdac4) != HAL_OK)
  {
    Error_Handler();
  }

  /** DAC channel OUT1 config
  */
  sConfig.DAC_HighFrequency = DAC_HIGH_FREQUENCY_INTERFACE_MODE_AUTOMATIC;
  sConfig.DAC_DMADoubleDataMode = DISABLE;
  sConfig.DAC_SignedFormat = DISABLE;
  sConfig.DAC_SampleAndHold = DAC_SAMPLEANDHOLD_DISABLE;
  sConfig.DAC_Trigger = DAC_TRIGGER_NONE;
  sConfig.DAC_Trigger2 = DAC_TRIGGER_NONE;
  sConfig.DAC_OutputBuffer = DAC_OUTPUTBUFFER_DISABLE;
  sConfig.DAC_ConnectOnChipPeripheral = DAC_CHIPCONNECT_INTERNAL;
  sConfig.DAC_UserTrimming = DAC_TRIMMING_FACTORY;
  if (HAL_DAC_ConfigChannel(&hdac4, &sConfig, DAC_CHANNEL_1) != HAL_OK)
  {
    Error_Handler();
  }
  /* USER CODE BEGIN DAC4_Init 2 */
  HAL_DACEx_SelfCalibrate(&TRG_B_DAC,&sConfig,TRG_B_DAC_CHANNEL);
  /* USER CODE END DAC4_Init 2 */

}

void HAL_DAC_MspInit(DAC_HandleTypeDef* dacHandle)
{

  GPIO_InitTypeDef GPIO_InitStruct = {0};
  if(dacHandle->Instance==DAC1)
  {
    /* DAC1 clock enable */
    __HAL_RCC_DAC1_CLK_ENABLE();

    __HAL_RCC_GPIOA_CLK_ENABLE();
    /**DAC1 GPIO Configuration
    PA4     ------> DAC1_OUT1
    PA5     ------> DAC1_OUT2
    */
    GPIO_InitStruct.Pin = DAC1_1_Pin|DAC1_2_Pin;
    GPIO_InitStruct.Mode = GPIO_MODE_ANALOG;
    GPIO_InitStruct.Pull = GPIO_NOPULL;
    HAL_GPIO_Init(GPIOA, &GPIO_InitStruct);

  }
  else if(dacHandle->Instance==DAC2)
  {
    /* DAC2 clock enable */
    __HAL_RCC_DAC2_CLK_ENABLE();

    __HAL_RCC_GPIOA_CLK_ENABLE();
    /**DAC2 GPIO Configuration
    PA6     ------> DAC2_OUT1
    */
    GPIO_InitStruct.Pin = DAC2_1_Pin;
    GPIO_InitStruct.Mode = GPIO_MODE_ANALOG;
    GPIO_InitStruct.Pull = GPIO_NOPULL;
    HAL_GPIO_Init(DAC2_1_GPIO_Port, &GPIO_InitStruct);

    /* DAC2 DMA Init */
    /* DAC2_CH1 Init */
    hdma_dac2_ch1.Instance = DMA1_Channel1;
    hdma_dac2_ch1.Init.Request = DMA_REQUEST_DAC2_CHANNEL1;
    hdma_dac2_ch1.Init.Direction = DMA_MEMORY_TO_PERIPH;
    hdma_dac2_ch1.Init.PeriphInc = DMA_PINC_DISABLE;
    hdma_dac2_ch1.Init.MemInc = DMA_MINC_ENABLE;
    hdma_dac2_ch1.Init.PeriphDataAlignment = DMA_PDATAALIGN_WORD;
    hdma_dac2_ch1.Init.MemDataAlignment = DMA_MDATAALIGN_WORD;
    hdma_dac2_ch1.Init.Mode = DMA_CIRCULAR;
    hdma_dac2_ch1.Init.Priority = DMA_PRIORITY_LOW;
    if (HAL_DMA_Init(&hdma_dac2_ch1) != HAL_OK)
    {
      Error_Handler();
    }

    __HAL_LINKDMA(dacHandle,DMA_Handle1,hdma_dac2_ch1);

    /* DAC2 interrupt Init */
    HAL_NVIC_SetPriority(TIM7_DAC_IRQn, 15, 0);
    HAL_NVIC_EnableIRQ(TIM7_DAC_IRQn);
  }
  else if(dacHandle->Instance==DAC3)
  {
    /* DAC3 clock enable */
    __HAL_RCC_DAC3_CLK_ENABLE();
  }
  else if(dacHandle->Instance==DAC4)
  {
    /* DAC4 clock enable */
    __HAL_RCC_DAC4_CLK_ENABLE();

    /* DAC4 interrupt Init */
    HAL_NVIC_SetPriority(TIM7_DAC_IRQn, 15, 0);
    HAL_NVIC_EnableIRQ(TIM7_DAC_IRQn);
  }
}

void HAL_DAC_MspDeInit(DAC_HandleTypeDef* dacHandle)
{

  if(dacHandle->Instance==DAC1)
  {
    /* Peripheral clock disable */
    __HAL_RCC_DAC1_CLK_DISABLE();

    /**DAC1 GPIO Configuration
    PA4     ------> DAC1_OUT1
    PA5     ------> DAC1_OUT2
    */
    HAL_GPIO_DeInit(GPIOA, DAC1_1_Pin|DAC1_2_Pin);

  }
  else if(dacHandle->Instance==DAC2)
  {
    /* Peripheral clock disable */
    __HAL_RCC_DAC2_CLK_DISABLE();

    /**DAC2 GPIO Configuration
    PA6     ------> DAC2_OUT1
    */
    HAL_GPIO_DeInit(DAC2_1_GPIO_Port, DAC2_1_Pin);

    /* DAC2 DMA DeInit */
    HAL_DMA_DeInit(dacHandle->DMA_Handle1);

    /* DAC2 interrupt Deinit */
  /* USER CODE BEGIN DAC2:TIM7_DAC_IRQn disable */
    /**
    * Uncomment the line below to disable the "TIM7_DAC_IRQn" interrupt
    * Be aware, disabling shared interrupt may affect other IPs
    */
    /* HAL_NVIC_DisableIRQ(TIM7_DAC_IRQn); */
  /* USER CODE END DAC2:TIM7_DAC_IRQn disable */

  }
  else if(dacHandle->Instance==DAC3)
  {
    /* Peripheral clock disable */
    __HAL_RCC_DAC3_CLK_DISABLE();
  }
  else if(dacHandle->Instance==DAC4)
  {
    /* Peripheral clock disable */
    __HAL_RCC_DAC4_CLK_DISABLE();

    /* DAC4 interrupt Deinit */
  /* USER CODE BEGIN DAC4:TIM7_DAC_IRQn disable */
    /**
    * Uncomment the line below to disable the "TIM7_DAC_IRQn" interrupt
    * Be aware, disabling shared interrupt may affect other IPs
    */
    /* HAL_NVIC_DisableIRQ(TIM7_DAC_IRQn); */
  /* USER CODE END DAC4:TIM7_DAC_IRQn disable */

  }
}
