elmot/FoxilloScope/Core/Src/oscilloscope.cpp

#include "tim.h"
#include "dma.h"
#include "dac.h"
#include <array>
#include <atomic>
#include <span>
#include "oscilloscope.hpp"
#include <cstring>
#include <algorithm>
#include <climits>
#include <version.h>

#include "adc.h"
#include "cmsis_os2.h"
#include "opamp.h"

alignas(uint32_t) static std::array<uint16_t, data_frame_size * 2> adcBufferA{};

alignas(uint32_t) static std::array<uint16_t, data_frame_size * 2> adcBufferB{};

// ReSharper disable once CppTemplateArgumentsCanBeDeduced
static std::atomic<int> partialSamplesSent = -1;

constexpr auto bufferHalves = std::array{
    std::pair(std::span(adcBufferA).first<data_frame_size>(),
              std::span(adcBufferB).first<data_frame_size>()),

    std::pair(std::span(adcBufferA).last<data_frame_size>(),
              std::span(adcBufferB).last<data_frame_size>())
};

static void dmaMemToMemCallback(DMA_HandleTypeDef* dma_handle_type_def);

static void initialize_test_signal()
{
    //#ifdef DEBUG
    extern const unsigned short fake_signal[];
    HAL_DAC_Start_DMA(&TEST_SIGNAL_DAC, TEST_SIGNAL_DAC_CHANNEL, reinterpret_cast<const uint32_t*>(fake_signal), 164,
                      DAC_ALIGN_12B_R);
    //__HAL_TIM_SET_PRESCALER(&htim15, 30000);
    HAL_TIM_Base_Start(&htim15);
    //#endif
}

/** Oscilloscope commands
 *
 */
namespace
{
    constexpr struct CommandTimeResolution_t : Command_t
    {
        static constexpr long minAdcTime = 1'000'000'000LL / 4'000'000; // 4 MHz ADC max sampling

        constexpr CommandTimeResolution_t() : Command_t("sampling.ns", 250,
                                                        1'000'000'000LL / 8'000'000, // 8 MHz max sampling freq in nsec
                                                        1'000'000'000LL / 20, // 20 Hz min sampling freq in nsec
                                                        true)
        {
        }

        bool isInterleaveSampling() const
        {
            return value < minAdcTime;
        }

        uint32_t clockDivider() const
        {
            if (LL_RCC_GetAPB1Prescaler() != LL_RCC_APB1_DIV_1)
            {
                //APB1 divider must be 1
                Error_Handler();
            }
            // twice slower if interleaved sampling
            unsigned long long fullDivider = isInterleaveSampling() ? 2 : 1;
            fullDivider = fullDivider * (500'000'000ULL + HAL_RCC_GetPCLK1Freq() * static_cast<unsigned long long>(
                    value)) /
                1'000'000'000ULL;
            return static_cast<uint32_t>(fullDivider - 1);
        }
    } CommandTimeResolution{};
}

namespace trigger
{
    // ReSharper disable once CppTemplateArgumentsCanBeDeduced
    static std::atomic<TriggerState> state = TriggerState::DISARMED;
    // ReSharper disable once CppTemplateArgumentsCanBeDeduced
    static std::atomic<int> pre_arming = 0;

    namespace
    {
        constexpr struct CommandTriggerLevel_t : Command_t
        {
            constexpr CommandTriggerLevel_t() : Command_t("trigger.lvl.ppm", 0L, -1'000'000, 1'000'000)
            {
            }

            void useNewValue() const override
            {
                constexpr long long dac_max_long_long = DAC_MAX_VALUE;
                const uint16_t dac_trg_bias = std::ranges::clamp((max - value) * dac_max_long_long / (max - min), 0LL,
                                                             dac_max_long_long);
                HAL_DAC_SetValue(&VGND_TRG_A_DAC, TRG_A_DAC_CHANNEL,DAC_ALIGN_12B_R, dac_trg_bias);
                HAL_DAC_SetValue(&TRG_B_DAC, TRG_B_DAC_CHANNEL,DAC_ALIGN_12B_R, dac_trg_bias);
            }
        } CommandTriggerLevel{};

        constexpr struct CommandTriggerType_t : Command_t
        {
            constexpr CommandTriggerType_t() : Command_t("trg.type", 0, -1, 1, true)
            {
            }
        } CommandTriggerType{};

        constexpr struct CommandTriggerOffset_t : Command_t
        {
            constexpr CommandTriggerOffset_t() : Command_t("trg.time.offset", 0, -1'000'000, 1'000'000, true)
            {
            }

            int timerShiftSamples() const
            {
                constexpr long range = data_frame_size;
                return static_cast<int>(range * value / max);
            }
        } CommandTriggerOffset{};

        constexpr struct CommandTriggerChannel_t : Command_t
        {
            constexpr CommandTriggerChannel_t() : Command_t("trg.chan", 0, 0, 1, true)
            {
            }
        } CommandTriggerChannel{};

        void enableTrigger()
        {
            if (CommandTriggerType.getValue() == 0)
            {
                HAL_NVIC_DisableIRQ(COMP1_2_3_IRQn);
                HAL_NVIC_DisableIRQ(COMP7_IRQn);
            }
            else
            {
                state = TriggerState::DISARMED;
                HAL_NVIC_EnableIRQ(COMP1_2_3_IRQn);
                HAL_NVIC_EnableIRQ(COMP7_IRQn);
            }
        }
    }

    static uint32_t comparatorValue()
    {
        return CommandTriggerType.getValue() == -1 ? COMP_OUTPUT_LEVEL_HIGH : COMP_OUTPUT_LEVEL_LOW;
    }
}

constexpr CommandBaseLevelUv_t CommandBaseLevelA{
    "base.lvl.a.uv", &BIAS_DAC,BIAS_DAC_CHANNEL_A, "gain.a", &STAGE_A1_OPAMP, &STAGE_A2_OPAMP
};

constexpr CommandBaseLevelUv_t CommandBaseLevelB{
    "base.lvl.b.uv", &BIAS_DAC,BIAS_DAC_CHANNEL_B, "gain.b", &STAGE_B1_OPAMP, &STAGE_B2_OPAMP
};

namespace
{
    struct StartSysBootloader_t : Command_t
    {
        static constexpr long MAGIC_NUMBER = 0xB007; //BOOT

        StartSysBootloader_t() : Command_t("bootloader", 0, 0, LONG_MAX, false)
        {
        }

        void useNewValue() const override
        {
            if (value == MAGIC_NUMBER)
            {
                startSysBootloader();
            }
        }

        void write() const override
        {
        }
    };

    StartSysBootloader_t StartSysBootloader{};

    struct ReadVersion_t : Command_t
    {
        ReadVersion_t() : Command_t("version", 0, 0, 1, false)
        {
        }

        void write() const override
        {
            if (value == 0) return;
            value = 0;
            writeUart("version=" BUILD_VERSION "\n");
        }
    };
}

static ReadVersion_t ReadVersion{};

constexpr std::array<const Command_t*, 11> commands{
    &CommandBaseLevelA,
    &CommandBaseLevelB,
    &CommandBaseLevelA.gain_cmd,
    &CommandBaseLevelB.gain_cmd,
    &CommandTimeResolution,
    &trigger::CommandTriggerLevel,
    &trigger::CommandTriggerType,
    &trigger::CommandTriggerOffset,
    &trigger::CommandTriggerChannel,
    &StartSysBootloader,
    &ReadVersion,
};

static void startSampling()
{
    partialSamplesSent = -1;
    if (trigger::CommandTriggerChannel.getValue() == 0)
    {
        __HAL_COMP_COMP2_EXTI_ENABLE_IT();
        __HAL_COMP_COMP7_EXTI_DISABLE_IT();
    }
    else
    {
        __HAL_COMP_COMP7_EXTI_ENABLE_IT();
        __HAL_COMP_COMP2_EXTI_DISABLE_IT();
    }
    int arr = trigger::CommandTriggerOffset.timerShiftSamples() + static_cast<int>(data_frame_size);
    if (arr < 0) arr = 0;
    if (CommandTimeResolution.isInterleaveSampling()) arr /= 2;
    arr = std::ranges::clamp(arr, 1, 1000);
#ifdef __CLION_IDE__
#pragma clang diagnostic push
#pragma clang diagnostic ignored "-Wdeprecated-volatile"
#endif
    __HAL_TIM_SET_COMPARE(&htim1, TIM_CHANNEL_1, arr);
#ifdef __CLION_IDE__
#pragma clang diagnostic pop
#endif
    __HAL_TIM_SET_COUNTER(&htim1, 0);
    startMainAdcs(CommandTimeResolution.isInterleaveSampling(), adcBufferA.data(), adcBufferB.data(),
                  adcBufferA.size());
    __HAL_TIM_SET_PRESCALER(&htim2, 0);
    __HAL_TIM_SET_AUTORELOAD(&htim2, CommandTimeResolution.clockDivider());
    __HAL_TIM_SET_COUNTER(&htim2, 0);
    HAL_TIM_Base_Start(&htim2);
    HAL_NVIC_ClearPendingIRQ(COMP1_2_3_IRQn);
    trigger::pre_arming = trigger::CommandTriggerOffset.timerShiftSamples() < 0 ? 2 : 0;
    trigger::enableTrigger();
}

static void executeIncomingCommand()
{
    static char cmdBuffer[2064];
    cmdBuffer[0] = 0;
    for (size_t i = 0; true; i = (i + 1) % sizeof(cmdBuffer))
    {
        osMessageQueueGet(cmdRxQueueHandle, &cmdBuffer[i], nullptr,osWaitForever);
        if (cmdBuffer[i] == '\n' || cmdBuffer[i] == '\r')
        {
            cmdBuffer[i] = 0;
            break;
        }
    }

    char* noSpacePtr = cmdBuffer;
    skipWhiteSpace(noSpacePtr);
    if (strlen(noSpacePtr) == 0) return;
    bool requiresRestart = false;
    for (const auto& command : commands)
    {
        char* ptr = noSpacePtr;
        if (strncmp(ptr, command->name.data(), command->name.size()) != 0) continue;
        ptr += command->name.size();
        skipWhiteSpace(ptr);
        if (*ptr++ != '=') continue;

        long newValue;
        const auto [cookie_ptr,err_code] = std::from_chars(ptr, ptr + strlen(ptr), newValue);
        if (err_code != std::errc{}) continue;
        if (command->setValue(newValue))
        {
            requiresRestart |= command->requires_restart;
        }
    }
    if (requiresRestart)
    {
        startSampling();
    }
}

extern osThreadId_t transmitTaskHandle;

[[noreturn]] void run_oscilloscope()
{
    initialize_test_signal();
    adcCalibration();
    HAL_DMA_RegisterCallback(&hdma_memtomem_dma1_channel2, HAL_DMA_XFER_CPLT_CB_ID, dmaMemToMemCallback);

    for (const auto opamp : {&STAGE_A1_OPAMP, &STAGE_A2_OPAMP, &STAGE_B1_OPAMP, &STAGE_B2_OPAMP, &VGND_OPAMP})
    {
        HAL_OPAMP_SelfCalibrate(opamp);
    }

    {  // Virtual ground
        HAL_DAC_Start(&VGND_TRG_A_DAC, VGND_DAC_CHANNEL);
        HAL_DAC_SetValue(&VGND_TRG_A_DAC, VGND_DAC_CHANNEL, DAC_ALIGN_12B_R, (DAC_MAX_VALUE + 1) / 2);
        HAL_OPAMP_Start(&VGND_OPAMP);
    }
    HAL_DAC_Start(&VGND_TRG_A_DAC, TRG_A_DAC_CHANNEL);
    HAL_DAC_Start(&TRG_B_DAC, TRG_B_DAC_CHANNEL);
    HAL_DAC_Start(&BIAS_DAC, BIAS_DAC_CHANNEL_A);
    HAL_DAC_Start(&BIAS_DAC, BIAS_DAC_CHANNEL_B);
    TIM_CCxChannelCmd(htim1.Instance, TIM_CHANNEL_1, TIM_CCx_ENABLE);
    HAL_TIM_IC_Start_IT(&htim1, TIM_CHANNEL_1);
    HAL_TIM_Base_Start(&htim1);
    startSampling();
    HAL_COMP_Start(&COMP_A);
    HAL_COMP_Start(&COMP_B);
    for (const auto& command : commands)
    {
        command->useNewValue();
    }
    startUartInput();
    startSampling();
    osThreadFlagsSet(transmitTaskHandle, THREAD_FLAG_READY_TO_TRANSMIT);

    osTimerStart(partialFrameTimerHandle, msec_to_ticks(50));
    while (true)
    {
        executeIncomingCommand();
    }
}

static void signalTransmit()
{
    osThreadFlagsSet(transmitTaskHandle, THREAD_FLAG_READY_TO_TRANSMIT);
}

static void initPartialFrameTransfer(const int subBufferIndex, const int start_index, const size_t length)
{
    --trigger::pre_arming;
    const auto& [fromA, fromB] = bufferHalves[subBufferIndex];
    if (osSemaphoreAcquire(transmitBuffer.semaphore, 0) != osOK)
    {
        //transmit buffer busy, skip the frame
        return;
    }
    transmitBuffer.length = length;
    transmitBuffer.head = start_index == 0;
    std::memcpy(transmitBuffer.samplesA.data(), fromA.data() + start_index, length * sizeof(uint16_t));
    std::memcpy(transmitBuffer.samplesB.data(), fromB.data() + start_index, length * sizeof(uint16_t));
    signalTransmit();
}


extern "C" void initFrameTransfer(const int subBufferIndex)
{
    initPartialFrameTransfer(subBufferIndex, 0, data_frame_size);
    partialSamplesSent = -1;
}

void dmaMemToMemCallback([[maybe_unused]] DMA_HandleTypeDef* dma_handle_type_def)
{
    HAL_DMA_PollForTransfer(&hdma_memtomem_dma1_channel6, HAL_DMA_FULL_TRANSFER, 10000);
    signalTransmit();
}

// ReSharper disable once CppParameterMayBeConstPtrOrRef
void HAL_COMP_TriggerCallback(COMP_HandleTypeDef* hcomp)
{
    if (trigger::pre_arming > 0) return;
    if (HAL_COMP_GetOutputLevel(hcomp) == trigger::comparatorValue())
    {
        if (trigger::state == TriggerState::ARMED)
        {
            trigger::state = TriggerState::TRIGGERED;
            __HAL_TIM_ENABLE(&htim1);
            HAL_NVIC_DisableIRQ(COMP1_2_3_IRQn);
            HAL_NVIC_DisableIRQ(COMP7_IRQn);
        }
    }
    else
    {
        trigger::state = TriggerState::ARMED;
    }
}

extern "C" void HAL_TIM_PWM_PulseFinishedCallback([[maybe_unused]] TIM_HandleTypeDef* htim)
{
    HAL_TIM_Base_Stop_IT(&htim1);
    HAL_TIM_Base_Stop(&htim2);
    HAL_DMA_Abort(hadc3.DMA_Handle);
    HAL_DMA_Abort(hadc1.DMA_Handle);
    extern osThreadId_t keyFrameTaskHandle;
    osThreadFlagsSet(keyFrameTaskHandle, THREAD_FLAG_KEY_FRAME_DETECTED);
}

extern "C" [[noreturn]] void keyFramesProcessing([[maybe_unused]] void*)
{
    while (true)
    {
        osThreadFlagsWait(THREAD_FLAG_KEY_FRAME_DETECTED,osFlagsNoClear,osWaitForever);
        osSemaphoreAcquire(transmitKeyBuffer.semaphore, osWaitForever);
        transmitKeyBuffer.length = data_frame_size;
        transmitKeyBuffer.head = true;

        const auto dma_samples_left = adcSamplesLeft();
        if (dma_samples_left <= data_frame_size)
        {
            const auto frame_start_position = adcBufferA.size() - dma_samples_left - data_frame_size;
            memcpy(&transmitKeyBuffer.samplesA[0], &adcBufferA[frame_start_position],
                   data_frame_size * sizeof (adcBufferA[0]));
            memcpy(&transmitKeyBuffer.samplesB[0], &adcBufferB[frame_start_position],
                   data_frame_size * sizeof (adcBufferB[0]));
        }
        else
        {
            const auto first_chunk_len = dma_samples_left - data_frame_size;
            memcpy(&transmitKeyBuffer.samplesA[0], &adcBufferA[adcBufferA.size() - first_chunk_len],
                   first_chunk_len * sizeof (adcBufferA[0]));
            memcpy(&transmitKeyBuffer.samplesB[0], &adcBufferB[adcBufferB.size() - first_chunk_len],
                   first_chunk_len * sizeof (adcBufferB[0]));

            memcpy(&transmitKeyBuffer.samplesA[first_chunk_len], &adcBufferA[0],
                   (data_frame_size - first_chunk_len) * sizeof (adcBufferA[0]));
            memcpy(&transmitKeyBuffer.samplesB[first_chunk_len], &adcBufferB[0],
                   (data_frame_size - first_chunk_len) * sizeof (adcBufferB[0]));
        }
        osThreadFlagsClear(THREAD_FLAG_KEY_FRAME_DETECTED);
        transmitKeyBufferReady = true;
        signalTransmit();
        startSampling();
        trigger::enableTrigger();
        partialSamplesSent = -1;
    }
}

constexpr static std::pair<long, long> calculate_min_max_uV(const long gain, const long bias,
                                                            const long supply_voltage_uV)
{
    if (gain == 1) { return {-supply_voltage_uV / 2, supply_voltage_uV / 2}; }
    const long long amplitude_uV = supply_voltage_uV / gain;
    long long min_uV = bias - amplitude_uV / 2;
    long long max_uV = bias + amplitude_uV / 2;
    return {min_uV, max_uV};
}

static std::pair<long, long> calculate_min_max_uV(const CommandBaseLevelUv_t& bias)
{
    return calculate_min_max_uV(bias.gain_cmd.getValue(), bias.getValue(), analog_supply_voltage_mV * 1000L);
}

/**
 * Inline compile-time-test
 *
 * **/
namespace Test
{
    [[maybe_unused]] static constexpr void test_min_max()
    {
        {
            // ReSharper disable once CppUseStructuredBinding
            constexpr auto bounds = calculate_min_max_uV(32, 500'000, 2'500'000);
            static_assert(bounds.first == 460'938);
            static_assert(bounds.second == 539'062);
        }
        {
            // ReSharper disable once CppUseStructuredBinding
            constexpr auto bounds = calculate_min_max_uV(32, 0, 3'500'000);
            static_assert(bounds.first == -54'687);
            static_assert(bounds.second == 54'687);
        }
        // ReSharper disable once CppUseStructuredBinding
        constexpr auto bounds = calculate_min_max_uV(16, -1'000'000, 3'300'000);
        static_assert(bounds.first == -1'103'125);
        static_assert(bounds.second == -896'875);
    }
}

void writeCommands()
{
    for (auto& command : commands)
    {
        command->write();
    }
    writeUart("vltg.steps=" ADC_STEPS_STR "\n");
    const auto [minA, maxA] = calculate_min_max_uV(CommandBaseLevelA);
    const auto [minB, maxB] = calculate_min_max_uV(CommandBaseLevelB);
    Command_t::do_write_value("vltg.min.uv.a", minA);
    Command_t::do_write_value("vltg.max.uv.a", maxA);
    Command_t::do_write_value("vltg.min.uv.b", minB);
    Command_t::do_write_value("vltg.max.uv.b", maxB);
}

extern "C" void partialFrameSend([[maybe_unused]] void*)
{
    if (partialSamplesSent < 0)
    {
        partialSamplesSent = 0;
        return;
    }
    unsigned int dma_samples_left = adcSamplesLeft();
    const int subBufferIndex = dma_samples_left > data_frame_size ? 0 : 1;
    dma_samples_left %= data_frame_size;

    constexpr int lastSubFrameThresholdLow = data_frame_size * 2 / 100;
    constexpr int lastSubFrameThresholdHigh = data_frame_size * 95 / 100;
    constexpr int garbageDmaTail = 1;

    const int measuredSamples = static_cast<int>(data_frame_size) - dma_samples_left - garbageDmaTail; // NOLINT(cppcoreguidelines-narrowing-conversions)

    if (measuredSamples > lastSubFrameThresholdLow
        && measuredSamples < lastSubFrameThresholdHigh
        && partialSamplesSent >= 0
        && partialSamplesSent < measuredSamples)
    {
        initPartialFrameTransfer(subBufferIndex, partialSamplesSent, measuredSamples - partialSamplesSent);
        partialSamplesSent = measuredSamples;
    }
}
