elmot/FoxilloScope/Core/Src/data.c

const unsigned short fake_signal [] __attribute__((aligned(32))) = {
1000 + 1055	,
1000 + 1081	,
1000 + 1100	,
1000 + 1109	,
1000 + 1108	,
1000 + 1098	,
1000 + 1081	,
1000 + 1059	,
1000 + 1034	,
1000 + 1010	,
1000 + 989	,
1000 + 973	,
1000 + 963	,
1000 + 961	,
1000 + 965	,
1000 + 976	,
1000 + 991	,
1000 + 1008	,
1000 + 1026	,
1000 + 1043	,
1000 + 1056	,
1000 + 1065	,
1000 + 1069	,
1000 + 1068	,
1000 + 1062	,
1000 + 1052	,
1000 + 1040	,
1000 + 1027	,
1000 + 1014	,
1000 + 1003	,
1000 + 995	,
1000 + 991	,
1000 + 990	,
1000 + 993	,
1000 + 999	,
1000 + 1007	,
1000 + 1017	,
1000 + 1026	,
1000 + 1035	,
1000 + 1042	,
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
};
