elmot/FoxilloScope/Core/Src/transmit.cpp

#include <cstring>
#include <span>

#include "cmsis_os.h"
#include "oscilloscope.hpp"
#include "version.h"
#include "stm32g4xx_ll_usart.h"
#include "string"
#include "usart.h"

using namespace std;

extern osSemaphoreId_t transmitBufferBusyHandle; // NOLINT(*-dynamic-static-initializers)
extern osSemaphoreId_t transmitKeyBufferBusyHandle; // NOLINT(*-dynamic-static-initializers)

TransmitBuffer_t transmitBuffer{transmitBufferBusyHandle}; // NOLINT(*-interfaces-global-init)
TransmitBuffer_t transmitKeyBuffer{transmitKeyBufferBusyHandle}; // NOLINT(*-interfaces-global-init)

static constexpr char BASE64_CHARS[] = "ABCDEFGHIJKLMNOPQRSTUVWXYZabcdefghijklmnopqrstuvwxyz0123456789+/";

static constexpr size_t ascii_buffer_size = data_frame_size * 2 + 2;

static std::span<char> encode_bin_buffer(
    const std::span<uint16_t>& samples,
    array<char, ascii_buffer_size>& asciiBuffer)
{
    auto textPtr = asciiBuffer.begin();
    for (auto val : samples)
    {
        val = (0xFFF - val) & 0x0FFF;

        // Split the 12 bits into two 6-bit chunks
        const uint8_t high6 = (val >> 6) & 0x3F;
        const uint8_t low6 = val & 0x3F;

        *textPtr++ = BASE64_CHARS[high6];
        *textPtr++ = BASE64_CHARS[low6];
    }
    *textPtr++ = '\n';
    *textPtr = 0;
    return std::span{asciiBuffer.begin(), textPtr};
}


template <unsigned long N>
static consteval auto to_constexpr_string_cr()
{
    constexpr auto count_digits = []() constexpr -> size_t
    {
        char buf[100];
        return to_chars(buf, buf + sizeof(buf), N).ptr - buf;
    };
    constexpr size_t len = count_digits(); // (Use the count_digits func from earlier)
    array<char, len + 1> arr{};
    to_chars(arr.begin(), arr.end() - 1, N).ptr[0] = '\n';
    return arr;
}

static_assert(string_view(to_constexpr_string_cr<182>()) == string_view("182\n"));

std::atomic<bool> transmitKeyBufferReady{false};

extern "C" [[noreturn]] void startTransmitTask([[maybe_unused]] void* argument)
{
    static array<char, ascii_buffer_size> asciiBufferA;
    static array<char, ascii_buffer_size> asciiBufferB;
    osThreadFlagsWait(THREAD_FLAG_READY_TO_TRANSMIT, osFlagsWaitAny, osWaitForever);
    writeUart("\n#\nversion=" BUILD_VERSION "\nparam?\n");
    while (true)
    {
        writeUart("#\nframe.size=");
        writeUart(string_view(to_constexpr_string_cr<data_frame_size>()));
        const bool keyBuffer = transmitKeyBufferReady.exchange(false);
        TransmitBuffer_t* const buffer = keyBuffer ? &transmitKeyBuffer : &transmitBuffer;
        if (keyBuffer)
        {
            writeUart("keyframe=1\n");
        }
        if (buffer->head)
        {
            writeUart("head=1\n");
        }
        writeCommands();
        const auto& encodedA = encode_bin_buffer(span{buffer->samplesA.begin(),buffer->length}, asciiBufferA);
        writeUart("data.a=");
        writeUart(string_view{encodedA});
        const auto& encodedB = encode_bin_buffer(span{buffer->samplesB.begin(),buffer->length}, asciiBufferB);
        writeUart("data.b=");
        writeUart(string_view{encodedB});
        osSemaphoreRelease(transmitBuffer.semaphore);
        osSemaphoreRelease(transmitKeyBuffer.semaphore);
        osThreadFlagsWait(THREAD_FLAG_READY_TO_TRANSMIT, osFlagsWaitAny, osWaitForever);
    }
}

static atomic<osThreadId_t> transmittingTaskHandle = nullptr;
constexpr uint32_t UART_TX_BUSY = 0x1;

void writeUart(const string_view& str)
{
    if(str.empty()) return;
    transmittingTaskHandle = osThreadGetId();
    // Disable the DMA channel to allow configuration
    LL_DMA_DisableChannel(DMA1, LL_DMA_CHANNEL_4);
    LL_DMA_DisableChannel(DMA1, LL_DMA_CHANNEL_7);

    // Clear any prior transfer complete or error flags
    LL_DMA_ClearFlag_TC4(DMA1);
    LL_DMA_ClearFlag_TE4(DMA1);
    LL_DMA_ClearFlag_TC7(DMA1);
    LL_DMA_ClearFlag_TE7(DMA1);
    LL_USART_ClearFlag_TC(USART1);
    LL_USART_ClearFlag_TC(UART4);

    LL_DMA_SetMemoryAddress(DMA1, LL_DMA_CHANNEL_4, reinterpret_cast<uint32_t>(str.data()));
    LL_DMA_SetMemoryAddress(DMA1, LL_DMA_CHANNEL_7, reinterpret_cast<uint32_t>(str.data()));
    LL_DMA_SetDataLength(DMA1, LL_DMA_CHANNEL_4, str.size());
    LL_DMA_SetDataLength(DMA1, LL_DMA_CHANNEL_7, str.size());

    LL_DMA_SetPeriphAddress(DMA1, LL_DMA_CHANNEL_4, reinterpret_cast<uint32_t>(&USART1->TDR));
    LL_DMA_SetPeriphAddress(DMA1, LL_DMA_CHANNEL_7, reinterpret_cast<uint32_t>(&UART4->TDR));

    // Clear any pending notifications before starting the hardware
    osThreadFlagsClear(UART_TX_BUSY);
    // Enable the DMA Channel
    LL_DMA_EnableChannel(DMA1, LL_DMA_CHANNEL_7);
    LL_DMA_EnableIT_TC(DMA1, LL_DMA_CHANNEL_7);
    LL_USART_EnableDMAReq_TX(UART4);
    LL_DMA_EnableChannel(DMA1, LL_DMA_CHANNEL_4);
    LL_DMA_EnableIT_TC(DMA1, LL_DMA_CHANNEL_4);
    LL_USART_EnableDMAReq_TX(USART1);

    // Wait for the specific thread flag to be set by the ISR
    // This is immune to the race condition because even if the flag is set 1 microsecond
    // BEFORE this line executes, osThreadFlagsWait reads the already-set flag and moves on.
    osThreadFlagsWait(UART_TX_BUSY, osFlagsWaitAny, osWaitForever);

    while (!LL_USART_IsActiveFlag_TC(USART1) || !LL_USART_IsActiveFlag_TC(UART4))
    {
        osThreadYield();
    }
}

static void uartTransferComplete()
{
    if (transmittingTaskHandle != nullptr &&
        !LL_USART_IsEnabledDMAReq_TX(USART1)&&
        !LL_USART_IsEnabledDMAReq_TX(UART4))
    {
        // Signal the waiting task directly
        osThreadFlagsSet(transmittingTaskHandle, UART_TX_BUSY);
    }

}
extern "C" void usart1TransferComplete()
{
    if (LL_DMA_IsActiveFlag_TC4(DMA1))
    {
        // Clear the DMA interrupt flag
        LL_DMA_ClearFlag_TC4(DMA1);

        // Disable the UART DMA TX Request bit
        LL_USART_DisableDMAReq_TX(USART1);

        // Disable the DMA Channel (required before re-configuring NDTR for the next block)
        LL_DMA_DisableChannel(DMA1, LL_DMA_CHANNEL_4);
        uartTransferComplete();
    }
}

extern "C" void uart4TransferComplete()
{
    if (LL_DMA_IsActiveFlag_TC7(DMA1))
    {
        // Clear the DMA interrupt flag
        LL_DMA_ClearFlag_TC7(DMA1);

        // Disable the UART DMA TX Request bit
        LL_USART_DisableDMAReq_TX(UART4);

        // Disable the DMA Channel (required before re-configuring NDTR for the next block)
        LL_DMA_DisableChannel(DMA1, LL_DMA_CHANNEL_7);

        uartTransferComplete();
    }
}

void startUartInput()
{
    LL_USART_EnableIT_RXNE(USART1);
    LL_USART_EnableIT_RXNE(UART4);
}

extern "C" void uartReadByte(const uint8_t rxByte)
{
    if (std::isspace(rxByte) || std::isprint(rxByte)) //skip garbage bytes
    {
        osMessageQueuePut(cmdRxQueueHandle, &rxByte, 0, 0);
    }
}
