elmot/FoxilloScope/esp32-gateway/main/serial.c

#include <string.h>
#include "freertos/FreeRTOS.h"
#include "gateway.h"
#include "driver/uart.h"
// ReSharper disable once CppUnusedIncludeDirective
#include "soc/gpio_num.h"

#define UART_PORT UART_NUM_1
#define UART_BAUD 460800
#define UART_TX_PIN CONFIG_OSC_UART_TX
#define UART_RX_PIN CONFIG_OSC_UART_RX

#define BUF_SIZE 20000

static const char * TAG = "serial";
static QueueHandle_t s_uart_queue = nullptr;
static TaskHandle_t s_uart_rx_task_handle = nullptr;

void uart_write_str(const char *str)
{
    uart_write_bytes(UART_PORT, str, strlen(str));
}

void uart_prepare_for_flashing(void)
{
    if (s_uart_rx_task_handle != nullptr) {
        vTaskSuspend(s_uart_rx_task_handle);
    }
    const uart_config_t flasher_cfg = {
        .baud_rate = 115200,
        .data_bits = UART_DATA_8_BITS,
        .parity = UART_PARITY_EVEN,
        .stop_bits = UART_STOP_BITS_1,
        .flow_ctrl = UART_HW_FLOWCTRL_DISABLE,
        .source_clk = UART_SCLK_DEFAULT,
    };
    ESP_ERROR_CHECK(uart_param_config(UART_PORT, &flasher_cfg));
    uart_flush(UART_PORT);
}

[[noreturn]] static void uart_rx_task([[maybe_unused]] void *arg)
{
    static char buf[BUF_SIZE];
    static int len = 0;
    static bool discard = true;
    uart_event_t event;

    for (;;) {
        if (xQueueReceive(s_uart_queue, &event, portMAX_DELAY)) {
            switch (event.type) {
            case UART_DATA: {
                const int room = BUF_SIZE - 1 - len;
                const int n = event.size < room ? (int)event.size : room;
                uart_read_bytes(UART_PORT, buf + len, n, 0);
                len += n;

                if (discard) {
                    const char *hash = memchr(buf, '#', len);
                    if (hash) {
                        discard = false;
                        const int after = len - (hash - buf) - 1;
                        memmove(buf, hash + 1, after);
                        len = after;
                    } else {
                        len = 0;
                    }
                }

                if (!discard) {
                    char *hash;
                    while ((hash = memchr(buf, '#', len)) != NULL) {
                        const int idx = hash - buf;
                        if (idx > 0)
                        {
                            constexpr char keyframe_key[] = "keyframe=1";
                            const bool isKeyFrame = memmem(buf, idx, keyframe_key, sizeof(keyframe_key) -1) != nullptr;
                            scheduleTxMessage(buf, idx + 1, isKeyFrame);
                        }
                        const int after = len - idx - 1;
                        memmove(buf, hash + 1, after);
                        len = after;
                    }
                }
                buf[len] = '\0';
                break;
            }
            case UART_FRAME_ERR:
                ESP_LOGW(TAG, "UART frame error");
                break;
            case UART_FIFO_OVF:
                uart_flush_input(UART_PORT);
                break;
            default:
                break;
            }
        }
    }
}


void uart_init(void)
{
    static const uart_config_t cfg = {
        .baud_rate = UART_BAUD,
        .data_bits = UART_DATA_8_BITS,
        .parity = UART_PARITY_DISABLE,
        .stop_bits = UART_STOP_BITS_1,
        .flow_ctrl = UART_HW_FLOWCTRL_DISABLE,
        .source_clk = UART_SCLK_DEFAULT,
    };
    ESP_ERROR_CHECK(uart_param_config(UART_PORT, &cfg));
    ESP_ERROR_CHECK(uart_set_pin(UART_PORT, UART_TX_PIN, UART_RX_PIN, UART_PIN_NO_CHANGE, UART_PIN_NO_CHANGE));
    ESP_ERROR_CHECK(uart_driver_install(UART_PORT, 4096, 256, 20, &s_uart_queue, 0));
    xTaskCreate(uart_rx_task, "uart_rx_evt", 4096, nullptr, 10, &s_uart_rx_task_handle);
}
