elmot/FoxilloScope/(commit log)

2026-06-14 Run 782Hz triangle signal generation
    10bit, DAC1, Ch1, PA4, TIM2 trigger, Arduino A2 pin
2026-06-14 ADC simple sampling + UI improvements
2026-06-15 [PoC] Voltage shifter via DAC1 Ch1
2026-06-16 [PoC] Voltage shifter via DAC1 Ch1 - test signal
2026-06-16 ADC3/4 interleave for 2x sampling rate
    TIM3 does not trigger ADC2 anymore in favor of better inter-ADC timing
    ADC is in continuous mode, clocked from PLLP. Sampling freq to be adjusted via ADC clock prescaler + samping time (requires inter-adc delay adjustments).
    CPU freq: 150Mhz to let ADC be clocked from its max - 60MHz
    Problems: inter-adc calibration
    [adc.c, g4-oscilloscope-b.ioc, main.c, oscilloscope.cpp]
2026-06-16 Get rid of ST BSP; UART TX through DMA; UART speed 460800bps
2026-06-23 LPUART HAL->LL; get rid of (f)gets/fputs, thus fix race conditions in UART
    [g4-oscilloscope-b.ioc, main.h, oscilloscope.cpp, oscilloscope.hpp, transmit.cpp]
2026-06-23 Only one delimiter, lower UART speed
2026-06-23 Frequency selection - timers
    Now TIM2 => ADC clock, for it's 32bit ARR
2026-06-23 Selector fix, trigger type, gain channel A.
    [data.c, g4-oscilloscope-b.ioc, oscilloscope.cpp]
2026-06-23 Parameters sync with state number to prevent duplicate state updates
    [oscilloscope.cpp, oscilloscope.hpp]
2026-06-23 Bunch of fixes here and there
    [g4-oscilloscope-b.ioc, oscilloscope.cpp]
2026-06-23 Several fixes - ADC clocking & settings, html
    [adc.c, g4-oscilloscope-b.ioc, oscilloscope.cpp]
2026-06-24 Async python code + faster UART
2026-06-24 HTML fixes - better trigger buttons, remove unnecessary info
2026-06-26 Don't send useless periodic frames
2026-06-26 Fix trigger time shift
    [oscilloscope.cpp, oscilloscope.hpp]
2026-06-26 Partial frames
2026-06-26 Incremental partial frames
2026-06-27 Switch to inverted OPAMPs
    [adc.c, chart_server.py, dac.c, g4-oscilloscope-b.ioc, main.c]
2026-06-28 Remove on-device state-no, keep parameters in browser cookies
2026-06-30 Voltage is drawn on the chart(incomplete change)
2026-06-30 Fix dual mode which was broken because of Vref measurement as injected ADC1 sample
    [adc.c, g4-oscilloscope-b.ioc]
2026-06-30 Migration to uPlot, voltage is drawn on the chart
2026-07-01 Fix wiring diagram
2026-07-07 Pause button
2026-07-07 Wiring with protection circuit
2026-07-08 UART4 is a secondary uart
2026-07-09 ESP32 Wi-Fi gateway project
2026-07-09 ESP32 Wi-Fi supports mDNS & connection page
2026-07-09 LED support, UART pins via Kconfig, fixes
    [gateway.h, led.c, main.c, serial.c]
2026-07-09 HTML standalone resources, favicon, "[frame]" => "#" frame boundary, fixes
    [chart_server.py, gateway.h, led.c, main.c, serial.c, transmit.cpp, web-resources.c]
2026-07-10 Dynamic power adjustment by RSSI to reduce power consumption and interference.
    [main.c]
2026-07-20 Poll-down on both UART RX signals to avoid EMI from UART TX
    There may be false commands coming
    [g4-oscilloscope-b.ioc]
2026-07-20 Small fixes + rebranding to FoxilloScope
    [led.c]
2026-07-29 Better MCU analogue performance
    * CPU Freq = 120MHz
    * light sleep in idle task
    * All OPAMPs set to high speed
    * All output GPIOs set to low speed to reduce noise
    * All unused GPIOs set to analogue
    [foxilloscope.ioc, main.c, main.h]
2026-07-29 JS fixes and merges
    [web-resources.c]
2026-07-30 Use STM32 sys bootloader for firmware flashing via ESP32 UART
2026-07-31 Show STM32 firmware and ESP32 gateway versions
2026-07-31 Help Added
    [partition_table_2mb_huge_app.csv]
2026-07-31 Fix redirect in AP mode
    [web-resources.c]
2026-08-01 Small fixes and code optimization
    [oscilloscope.cpp, oscilloscope.hpp, transmit.cpp]
2026-10-09 Two-stage amplification
2026-10-09 New wiring documentation
2026-10-09 Wiring test code
    CMake is not finished yet
